burden-bear/Y3-DV-Devboard/README.md

# Y3-DV-Devboard
ESP32-S3 based devboard with onboard motor driver (DRV8848), 5V (TPS564255) and 3V (LDL1117S33TR) power regulation
