burden-bear/Y3-DV-Devboard/Y3-DV-Devboard/ESPNOW/ESPNOW.kicad_pcb

## KiCad design Y3-DV-Devboard/ESPNOW/ESPNOW.kicad_pcb (2025-08-05)

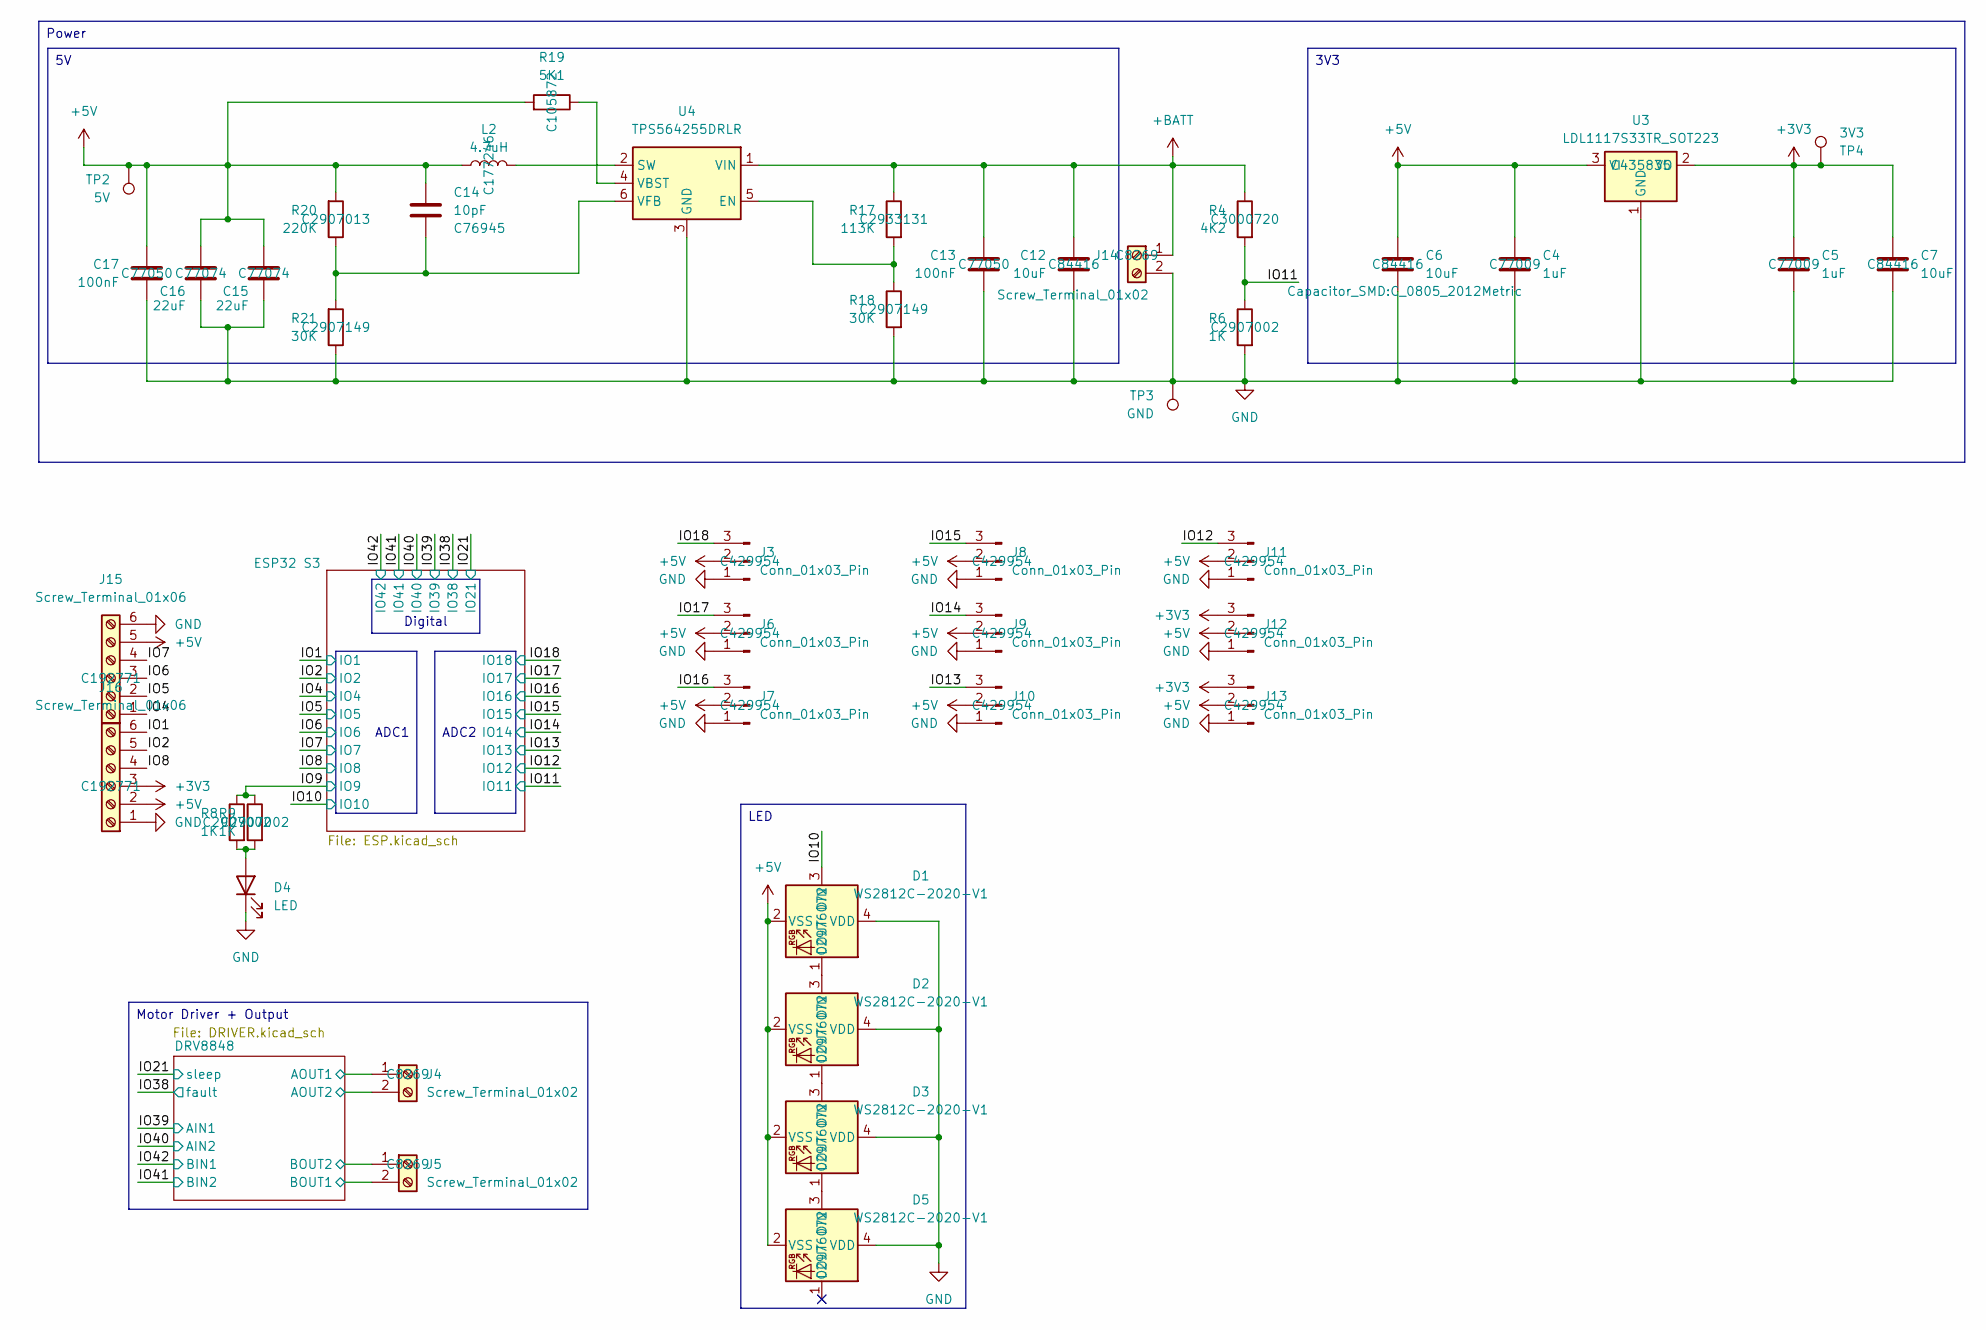
[picture p1: schematic ESPNOW.kicad_sch]

Parts:
C4, C5: 1uF; C_0402_1005Metric; LCSC Part # C77009
C6, C7, C12: 10uF; C_0805_2012Metric; LCSC Part # C84416
C13, C17: 100nF; C_0603_1608Metric; LCSC Part # C77050
C14: 10pF; C_0402_1005Metric; LCSC Part # C76945
C15, C16: 22uF; C_0805_2012Metric; LCSC Part # C77074
D1, D2, D3, D5: WS2812C-2020-V1; LED_WS2812B-2020_PLCC4_2.0x2.0mm; LCSC Part # C2976072
D4: LED; LED_0805_2012Metric
J3, J6, J7, J8, J9, J10, J11, J12, J13: Conn_01x03_Pin; PinHeader_1x03_P2.54mm_Vertical_0Yard; LCSC Part # C429954
J4, J5, J14: Screw_Terminal_01x02; TerminalBlock_MaiXu_MX126-5.0-02P_1x02_P5.00mm; LCSC Part # C8269
J15, J16: Screw_Terminal_01x06; TerminalBlock_MaiXu_MX126-5.0-06P_1x06_P5.00mm; LCSC Part # C192771
L2: 4.7uH; L_Changjiang_FXL0530; LCSC Part # C177246
R4: 4K2; R_0603_1608Metric; LCSC Part # C3000720
R6, R8, R9: 1K; R_0603_1608Metric; LCSC Part # C2907002
R17: 113K; R_0603_1608Metric; LCSC Part # C2933131
R18, R21: 30K; R_0603_1608Metric; LCSC Part # C2907149
R19: 5K1; R_0402_1005Metric; LCSC Part # C105872
R20: 220K; R_0603_1608Metric; LCSC Part # C2907013
TP2: 5V; TestPoint_Pad_D2.0mm
TP3: GND; TestPoint_Pad_D2.0mm
TP4: 3V3; TestPoint_Pad_D2.0mm
U3: LDL1117S33TR_SOT223; SOT-223-3_TabPin2; LCSC Part # C435835
U4: TPS564255DRLR; SOT-563; LCSC Part # C19272233

Connections:
+3V3: C5.1, C7.1, J12.3, J13.3, J16.3, TP4.1, U3.2 (VO); also elsewhere on the board
+5V: C4.1, C6.1, C14.1, C15.1, C16.1, C17.1, D1.2 (VSS), D2.2 (VSS), D3.2 (VSS), D5.2 (VSS), J3.2, J6.2, J7.2, J8.2, J9.2, J10.2, J11.2, J12.2, J13.2, J15.5, J16.2, L2.2, R19.2, R20.2, TP2.1, U3.3 (VI); also elsewhere on the board
+BATT: C12.1, C13.1, J14.1, R4.1, R17.1, U4.1 (VIN); also elsewhere on the board
/DRV8848/AOUT1: J4.1; also elsewhere on the board
/DRV8848/AOUT2: J4.2; also elsewhere on the board
/DRV8848/BOUT1: J5.2; also elsewhere on the board
/DRV8848/BOUT2: J5.1; also elsewhere on the board
/IO1: J16.6; also elsewhere on the board
/IO2: J16.5; also elsewhere on the board
/IO4: J15.1; also elsewhere on the board
/IO5: J15.2; also elsewhere on the board
/IO6: J15.3; also elsewhere on the board
/IO7: J15.4; also elsewhere on the board
/IO8: J16.4; also elsewhere on the board
/IO9: R8.1, R9.1; also elsewhere on the board
/IO10: D1.3 (DIN); also elsewhere on the board
/IO11: R4.2, R6.1; also elsewhere on the board
/IO12: J11.3; also elsewhere on the board
/IO13: J10.3; also elsewhere on the board
/IO14: J9.3; also elsewhere on the board
/IO15: J8.3; also elsewhere on the board
/IO16: J7.3; also elsewhere on the board
/IO17: J6.3; also elsewhere on the board
/IO18: J3.3; also elsewhere on the board
GND: C4.2, C5.2, C6.2, C7.2, C12.2, C13.2, C15.2, C16.2, C17.2, D1.4 (VDD), D2.4 (VDD), D3.4 (VDD), D4.1 (K), D5.4 (VDD), J3.1, J6.1, J7.1, J8.1, J9.1, J10.1, J11.1, J12.1, J13.1, J14.2, J15.6, J16.1, R6.2, R18.2, R21.1, TP3.1, U3.1 (GND), U4.3 (GND); also elsewhere on the board
unnamed: D1.1 (DOUT), D2.3 (DIN)
unnamed: D2.1 (DOUT), D3.3 (DIN)
unnamed: D3.1 (DOUT), D5.3 (DIN)
unnamed: D4.2 (A), R8.2, R9.2
unnamed: R17.2, R18.1, U4.5 (EN)
unnamed: L2.1, U4.2 (SW)
unnamed: R19.1, U4.4 (VBST)
unnamed: C14.2, R20.1, R21.2, U4.6 (VFB)

Notes on the sheet:
3V3
ADC1
LED
Motor Driver + Output
ADC2
Digital
Power

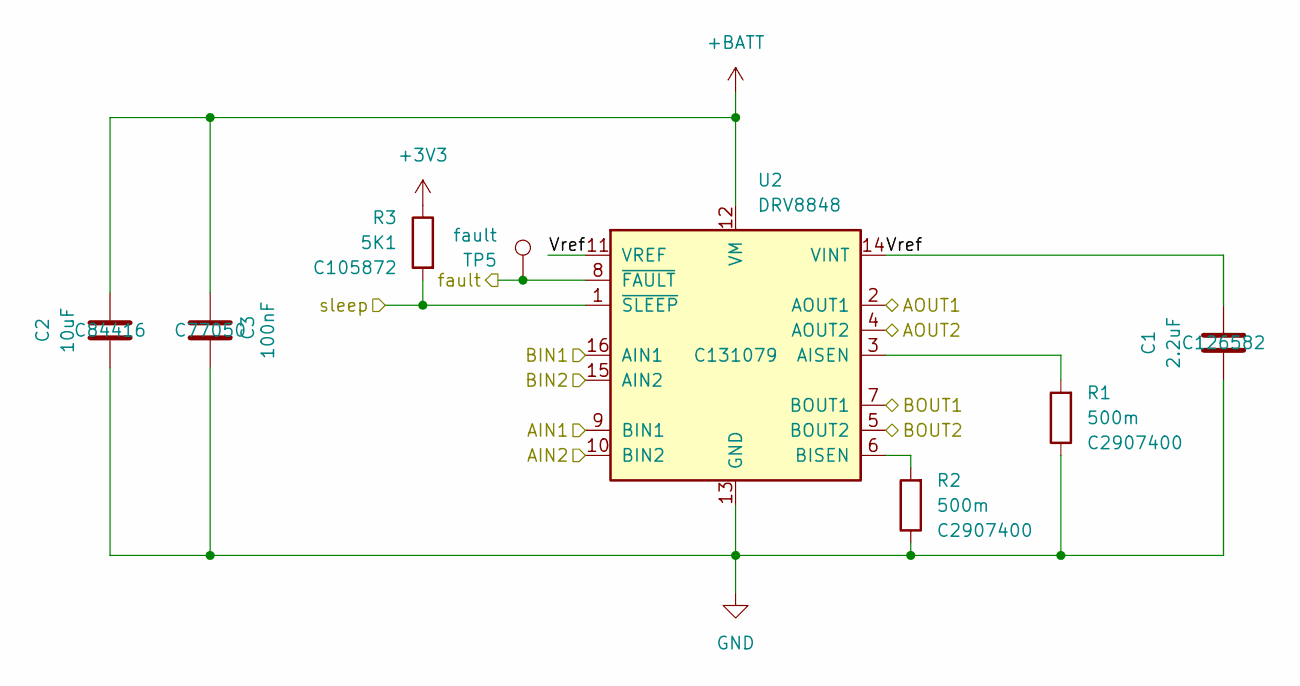
[picture p2: schematic DRIVER.kicad_sch]

Parts:
C1: 2.2uF; C_0603_1608Metric; LCSC Part # C126582
C2: 10uF; C_0805_2012Metric; LCSC Part # C84416
C3: 100nF; C_0603_1608Metric; LCSC Part # C77050
R1, R2: 500m; R_1206_3216Metric; LCSC Part # C2907400
R3: 5K1; R_0402_1005Metric; LCSC Part # C105872
TP5: fault; TestPoint_Pad_D2.0mm
U2: DRV8848; TSSOP-16-1EP_4.4x5mm_P0.65mm; LCSC Part # C131079

Connections:
+3V3: R3.1; also elsewhere on the board
+BATT: C2.2, C3.2, U2.12 (VM); also elsewhere on the board
/DRV8848/AOUT1: U2.2 (AOUT1); also elsewhere on the board
/DRV8848/AOUT2: U2.4 (AOUT2); also elsewhere on the board
/DRV8848/BOUT1: U2.7 (BOUT1); also elsewhere on the board
/DRV8848/BOUT2: U2.5 (BOUT2); also elsewhere on the board
/DRV8848/Vref: C1.2, U2.11 (VREF), U2.14 (VINT)
/IO21: R3.2, U2.1 (~SLEEP); also elsewhere on the board
/IO38: TP5.1, U2.8 (~FAULT); also elsewhere on the board
/IO39: U2.9 (BIN1); also elsewhere on the board
/IO40: U2.10 (BIN2); also elsewhere on the board
/IO41: U2.15 (AIN2); also elsewhere on the board
/IO42: U2.16 (AIN1); also elsewhere on the board
GND: C1.1, C2.1, C3.1, R1.1, R2.1, U2.13 (GND), U2.17 (GND); also elsewhere on the board
unnamed: R1.2, U2.3 (AISEN)
unnamed: R2.2, U2.6 (BISEN)

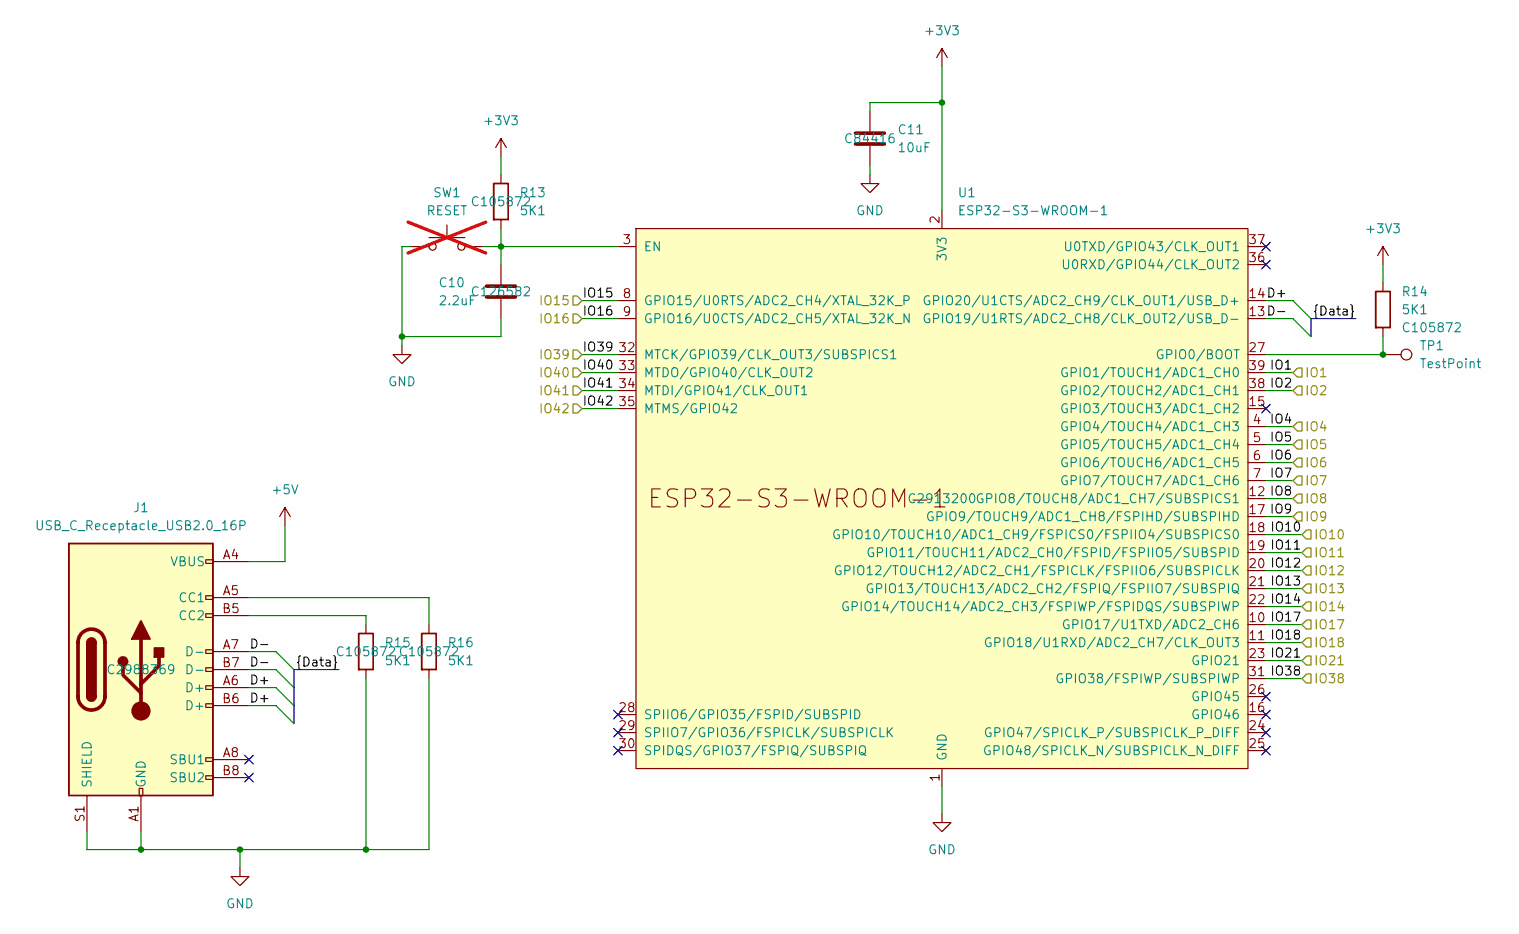
[picture p3: schematic ESP.kicad_sch]

Parts:
C10: 2.2uF; C_0603_1608Metric; LCSC Part # C126582
C11: 10uF; C_0805_2012Metric; LCSC Part # C84416
J1: USB_C_Receptacle_USB2.0_16P; USB_C_Receptacle_G-Switch_GT-USB-7010ASV; LCSC Part # C2988369
R13, R14, R15, R16: 5K1; R_0402_1005Metric; LCSC Part # C105872
SW1: RESET; SW_PUSH_6mm; not fitted
TP1: TestPoint; TestPoint_Pad_D2.0mm
U1: ESP32-S3-WROOM-1; LCSC Part # C2913200

Connections:
+3V3: C11.1, R13.1, R14.1, U1.2 (3V3); also elsewhere on the board
+5V: J1.A4 (VBUS), J1.A9 (VBUS), J1.B4 (VBUS), J1.B9 (VBUS); also elsewhere on the board
/ESP32 S3/D+: J1.A6 (D+), J1.B6 (D+), U1.14 (GPIO20/U1CTS/ADC2_CH9/CLK_OUT1/USB_D+)
/ESP32 S3/D-: J1.A7 (D-), J1.B7 (D-), U1.13 (GPIO19/U1RTS/ADC2_CH8/CLK_OUT2/USB_D-)
/IO1: U1.39 (GPIO1/TOUCH1/ADC1_CH0); also elsewhere on the board
/IO2: U1.38 (GPIO2/TOUCH2/ADC1_CH1); also elsewhere on the board
/IO4: U1.4 (GPIO4/TOUCH4/ADC1_CH3); also elsewhere on the board
/IO5: U1.5 (GPIO5/TOUCH5/ADC1_CH4); also elsewhere on the board
/IO6: U1.6 (GPIO6/TOUCH6/ADC1_CH5); also elsewhere on the board
/IO7: U1.7 (GPIO7/TOUCH7/ADC1_CH6); also elsewhere on the board
/IO8: U1.12 (GPIO8/TOUCH8/ADC1_CH7/SUBSPICS1); also elsewhere on the board
/IO9: U1.17 (GPIO9/TOUCH9/ADC1_CH8/FSPIHD/SUBSPIHD); also elsewhere on the board
/IO10: U1.18 (GPIO10/TOUCH10/ADC1_CH9/FSPICS0/FSPIIO4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); also elsewhere on the board
/IO11: U1.19 (GPIO11/TOUCH11/ADC2_CH0/FSPID/FSPIIO5/S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); also elsewhere on the board
/IO12: U1.20 (GPIO12/TOUCH12/ADC2_CH1/FSPICLK/FSPIIO6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); also elsewhere on the board
/IO13: U1.21 (GPIO13/TOUCH13/ADC2_CH2/FSPIQ/FSPIIO7/S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); also elsewhere on the board
/IO14: U1.22 (GPIO14/TOUCH14/ADC2_CH3/FSPIWP/FSPIDQS/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); also elsewhere on the board
/IO15: U1.8 (GPIO15/U0RTS/ADC2_CH4/XTAL_32K_P); also elsewhere on the board
/IO16: U1.9 (GPIO16/U0CTS/ADC2_CH5/XTAL_32K_N); also elsewhere on the board
/IO17: U1.10 (GPIO17/U1TXD/ADC2_CH6); also elsewhere on the board
/IO18: U1.11 (GPIO18/U1RXD/ADC2_CH7/CLK_OUT3); also elsewhere on the board
/IO21: U1.23 (GPIO21); also elsewhere on the board
/IO38: U1.31 (GPIO38/FSPIWP/SUBSPIWP); also elsewhere on the board
/IO39: U1.32 (MTCK/GPIO39/CLK_OUT3/SUBSPICS1); also elsewhere on the board
/IO40: U1.33 (MTDO/GPIO40/CLK_OUT2); also elsewhere on the board
/IO41: U1.34 (MTDI/GPIO41/CLK_OUT1); also elsewhere on the board
/IO42: U1.35 (MTMS/GPIO42); also elsewhere on the board
GND: C10.2, C11.2, J1.A1 (GND), J1.A12 (GND), J1.B1 (GND), J1.B12 (GND), J1.S1 (SHIELD), R15.2, R16.2, SW1.1, U1.1 (GND), U1.40 (GND), U1.41 (GND); also elsewhere on the board
unnamed: J1.A5 (CC1), R16.1
unnamed: J1.B5 (CC2), R15.1
unnamed: C10.1, R13.2, SW1.2, U1.3 (EN)
unnamed: R14.2, TP1.1, U1.27 (GPIO0/BOOT)

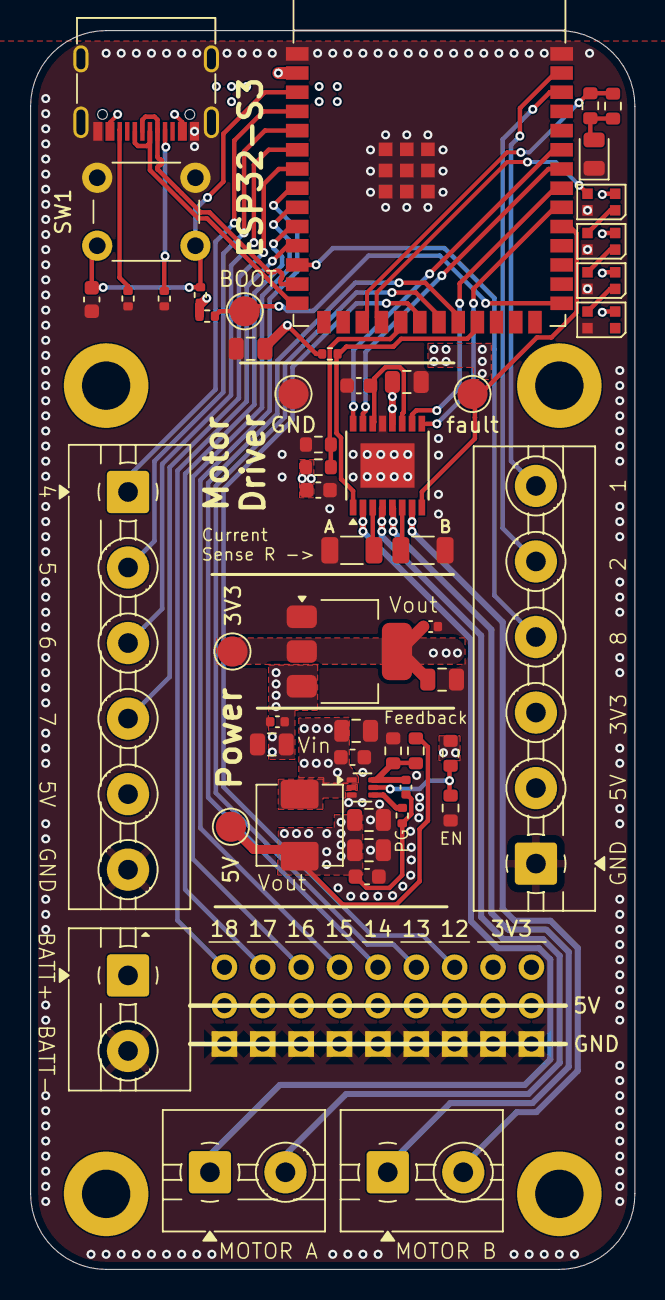
[picture p4: board ESPNOW.kicad_pcb from above]

Board: 4 copper layers, 40.0 x 82.0 mm, 63 parts (0 on the bottom side), 48 nets.

Other parts of the board:
REF: MountingHole_3.2mm_M3_DIN965_Pad
