burden-bear/Y3-DV-Devboard/(commit log)

2025-07-19 Add files via upload
    Committed finalised design, pending review.
    [20202812.kicad_sch, DRIVER.kicad_sch, ESP.kicad_sch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]
2025-08-05 Add files via upload
    Added back silkscreen for information
    Changed 3v3 LDO to power off 5V instead of Vbatt
    Minor changes to component part assignment to suit parts availability
    [20202812.kicad_sch, DRIVER.kicad_sch, ESP.kicad_sch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]
2025-08-05 Delete ESPNOW directory
    Removed duplicated file
    [20202812.kicad_sch, DRIVER.kicad_sch, ESP.kicad_sch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]
